lpender3672/sailboat/report/report.tex

\documentclass{article}

\usepackage[utf8]{inputenc}

\usepackage{amsmath, bm}
\usepackage{graphicx}
\usepackage{amssymb}
\usepackage{float}
\usepackage{caption}
\usepackage{subcaption}
\usepackage{hyperref}
\usepackage{tikz}
\usepackage{layout}
\usepackage{booktabs}

\usepackage[margin=1in]{geometry}
\usepackage{listings}
\usepackage{xcolor}
\usepackage{color, colortbl}
\usepackage{textgreek}
\usepackage{mathrsfs}

\usetikzlibrary{calc}
\usetikzlibrary{angles,quotes} % for pic
\usetikzlibrary{patterns,snakes}
\usetikzlibrary{arrows}
\tikzset{>=latex} % for LaTeX arrow head

\setlength{\parskip}{\baselineskip}%
\setlength{\parindent}{0pt}%
\linespread{0.9}

\definecolor{codegreen}{rgb}{0,0.6,0}
\definecolor{codegray}{rgb}{0.5,0.5,0.5}
\definecolor{codepurple}{rgb}{0.58,0,0.82}
\definecolor{backcolour}{rgb}{0.95,0.95,0.92}

\lstdefinestyle{mystyle}{
    backgroundcolor=\color{backcolour},   
    commentstyle=\color{codegreen},
    keywordstyle=\color{magenta},
    numberstyle=\tiny\color{codegray},
    stringstyle=\color{codepurple},
    basicstyle=\ttfamily\footnotesize,
    breakatwhitespace=false,         
    breaklines=true,                 
    captionpos=b,                    
    keepspaces=true,                 
    numbers=left,                    
    numbersep=5pt,                  
    showspaces=false,                
    showstringspaces=false,
    showtabs=false,                  
    tabsize=2
}

\lstset{style=mystyle}

\begin{document}

\title{Model Boat Analysis and Retrofit}
\author{Louis}
\date{September 2025}
\maketitle 

\iffalse
\begin{abstract}
    \centering

\end{abstract}
\fi

%-----------------------------------------------------------------------------------------
\section{Introduction}
%-----------------------------------------------------------------------------------------

% introduction to model boating in cornwall

% unique nice design two keels

A model boat was given to me by my uncle Robin whom he recieved from his uncle Bill.
The boat has a unique twin keel design with the hull being carved from a solid block of wood.

\section{Objective}

With this project being the largest and most complex geometry the objectives were made to test and further my skills in engineering.
My background in aerospace engineering puts me in a good position to tackle these problems and learn new skills in doing so.

\begin{itemize}
    \item Produce an accurate 3D model of the curved hull shape.
    \item Perform quasi-static bouyancy analysis to predict float plane for optimal propeller placement.
    \item Retrofit the boat with a new electric propulsion system.
    \item Write firmware to control the boat remotely using drone radio control equipment.
\end{itemize}

\section{CAD Modelling}

\begin{figure}[H]
    \centering
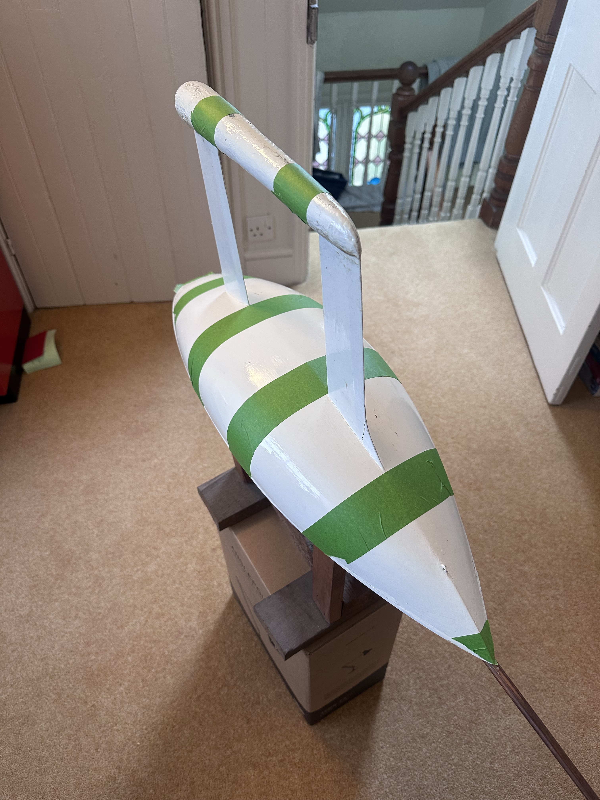
[picture p1: report/figures/IMG_3011.jpg]
    
    \caption{Tape on boat hull to prevent lidar reflections.}
    \label{fig:lidar_tape}
\end{figure}

\begin{figure}[H]
    \centering
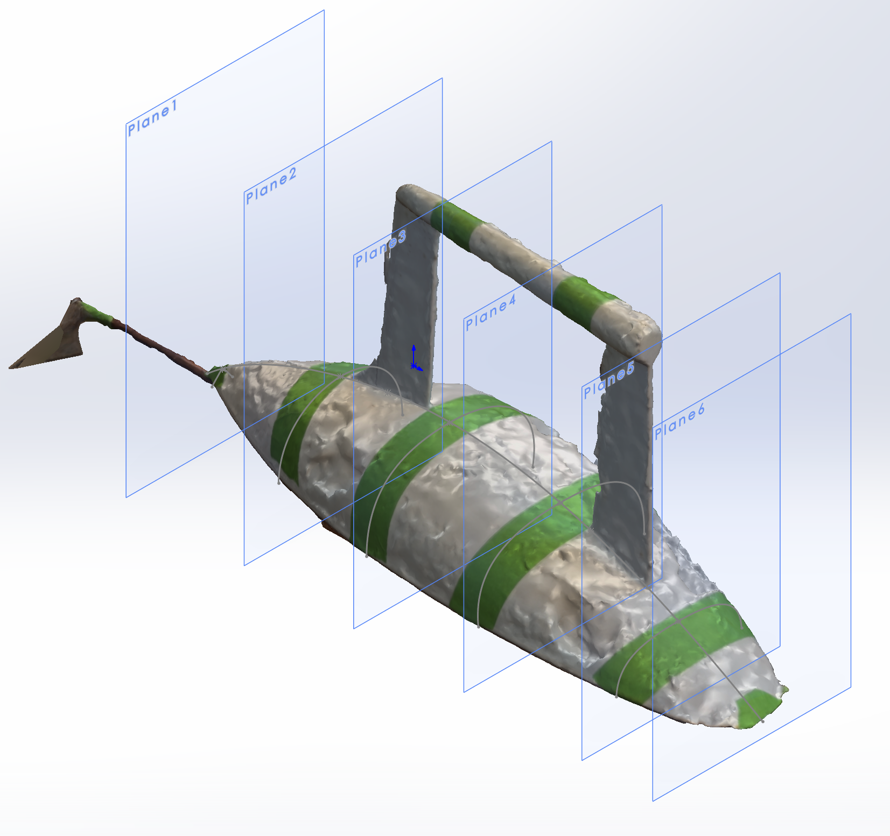
[picture p2: report/figures/2m8uCHP5jN.png]
    
    \caption{3D scan of the boat hull in the CAD package SOLIDWORKS.}
    \label{fig:3d_scan}
\end{figure}

Splines were drawn on the lines of tape which were the smoothest, most geometrically accurate parts of the scanned hull.
Large holes can be seen on the reflective white areas of the hull which was where lidar rays reflected, tricking the scanner into thinking the hull was further away than it actually was.
The splines were then lofted to create a smooth hull surface.
More complex features 

\section{Bouyancy Analysis}

It will be relevant to discuss some theory of bouyancy before discussing the analysis.

Archimedes' principle states that a body submerged in a fluid experiences an upward force equal to the weight of the fluid it displaces.
For the body to be in equilibrium, the bouyancy force must equal the weight of the body.
This simply means we must displace the volume of water that has the same weight as the boat.
However, the average location of the boats weight, known as the center of gravity (CG),
may be different to the averaged location of displaced fluid, known as the center of bouyancy (CB).
This is because even for a boat with evenly distributed weight (uniform density), the submerged volume will be different to the total volume.

When these two points are not aligned, a moment will be created which will cause the boat to rotate until equilibrium is reached.
When CG is aligned vertically above CB, it is possible to be in an unstable equilibrium where a small perturbation will cause the boat to capsize.
A stable equilibrium is reached when CG is vertically below CB, where a small perturbation will create a restoring moment to return the boat to equilibrium.
When CG is further below CB, a larger restoring moment exists and boat can roll to a more extreme angle before becoming unstable and capsizing.
This is why boats have dense keels, to lower the CG and increase stability.

To determine the float plane of the boat, a quasi-static bouyancy analysis was performed in python.
The description 'quasi-static' is used because dynamic fluid forces are not considered as this would require far more complex CFD analysis.
It then follows that this is only valid when the boat rocks or settles at low speeds where dynamic fluid forces ($\rho V^2$) are negligible.

The 3D model was exported as an STL file and processed using the numpy-stl package.
A function is created to slice the mesh 

A simple gui was created to view how the boat settles over time from the quasi-static solver.
Upon loading an STL file and clicking the solve float plane button, an animation plays of the boat settling.
Euler angles (roll, pitch, yaw) are plotted over time to show how the boat stabilises.

\begin{figure}[H]
    \centering
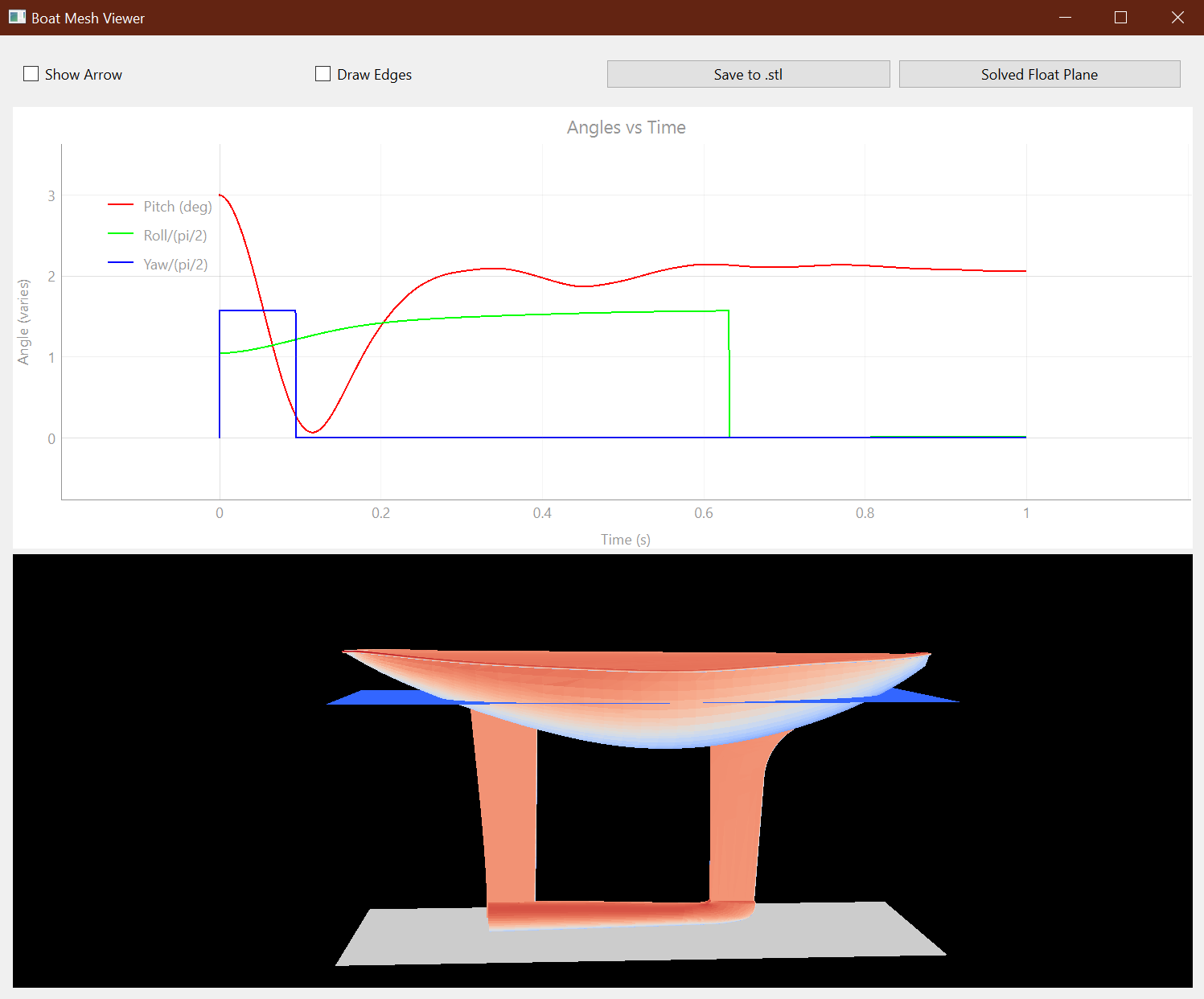
[picture p3: report/figures/XqMwPnm3wm.png]
    
    \caption{Boat bouyancy analysis GUI.}
    \label{fig:boat_gui}
\end{figure}

Figure \ref{fig:boat_gui} shows the solver running with the boat model loaded.
It starts from a perturbed position (3 degrees pitch and 1 degree roll) and settles to a stable equilibrium.
Step changes are seen in the angle plots which may be due to the discontinuities in the volume calculation.
To understand this better, the calculation of submerged volume is explained.

The STL mesh is a series of triangular facets defined by three vertices and a normal vector.
To find the submerged volume, only the traingles with all three vertices below the waterline are considered.
A fourth vertex is taken as the point that defines the water plane and the submerged volume is the sum of tetrahedrons formed by each triangle and this fourth vertex.
The tetrahedron's volume is calculated using the determinant method.
\begin{equation}
    V = \frac{1}{6} \begin{vmatrix}
        x_1 & y_1 & z_1 & 1 \\
        x_2 & y_2 & z_2 & 1 \\
        x_3 & y_3 & z_3 & 1 \\
        x_4 & y_4 & z_4 & 1
    \end{vmatrix}
\end{equation}
The discontinuities in the angle plots are likely due to triangles that are on the edge of being submerged or not.
When a small change in angle causes a triangle to become submerged, it will cause a step change in the volume,
which over many iterations hidden in the x axis scale, causes steep changes in the angle plots.

A smooth response in pitch can be seen which converges nicely to a stable equilibrium of $\sim2$ degrees pitch up.

\subsection{Propeller placement and specification}

An initial guess for the propeller size will be done using non dimensional analysis.
We would like to know the size and speed of the propeller for the size of hull and a target speed of 1.4 m/s (walking pace).

Non dimensional coefficients relevant to the problem are the advance ratio and thrust coefficient.
These are defined with their typical values for displace hull boats below.
\begin{equation}
    J = \frac{V}{nD} \approx 0.6
\end{equation}
\begin{equation}
    C_T = \frac{T}{\rho n^2 D^4} \approx 0.1
\end{equation}

Here $V$ is the boat velocity, $n$ the propeller rotational speed in revolutions per second, 
$D$ the propeller diameter, $T$ the thrust, and $\rho$ the water density.

\subsection*{Scaling relations}
From the definition of $J$, we can write
\begin{equation}
    n = \frac{V}{J D}.
\end{equation}
Substituting this into the definition of $C_T$ gives a relation between thrust, velocity, and propeller diameter:
\begin{equation}
    T = \rho n^2 D^4 C_T 
      = \rho \left( \frac{V}{J D} \right)^2 D^4 C_T.
\end{equation}
Rearranging for $D$ and $n$ yields scaling relations in terms of the boats required thrust (or drag) $T$, velocity $V$, and fluid density $\rho$:
\begin{equation}
    D = \sqrt{\frac{T J^2}{\rho V^2 C_T}},
\end{equation}
\begin{equation}
    n = \frac{V}{J D}.
\end{equation}

For our model boat of length $L = 0.66\,\text{m}$, advancing at walking speed 
$V \approx 1.4\,\text{m/s}$, we adopt $\rho = 1000\,\text{kg/m}^3$, $J = 0.6$, and $C_T = 0.1$.
The required thrust is estimated in the range $T = 2\text{--}4\,\text{N}$ to overcome hull resistance.

\paragraph{Lower drag case ($T=2$\,N):}
\begin{align}
    D &\approx 0.061\,\text{m} \\
    n &\approx 38.5 \,\text{rev/s} \; (2310\,\text{RPM})
\end{align}

\paragraph{Higher drag case ($T=4$\,N):}
\begin{align}
    D &\approx 0.086\,\text{m} \\
    n &\approx 27.2 \,\text{rev/s} \; (1630\,\text{RPM})
\end{align}

These results show that for the target Froude number ($Fr \approx 0.55$), 
propeller diameters in the range $60$--$90$\,mm with rotational speeds 
$1600$--$2300$\,RPM are consistent with typical open-water coefficients.
If physical constraints limit the diameter below this range, higher rotational 
speeds and larger thrust coefficients must be accepted, leading to lower efficiency.

\subsection{CFD analysis of hull resistance}

A CFD analysis was done in solidworks flow simulation to estimate the drag of the hull at the target speed of 1.4 m/s.

\begin{figure}[H]
    \centering
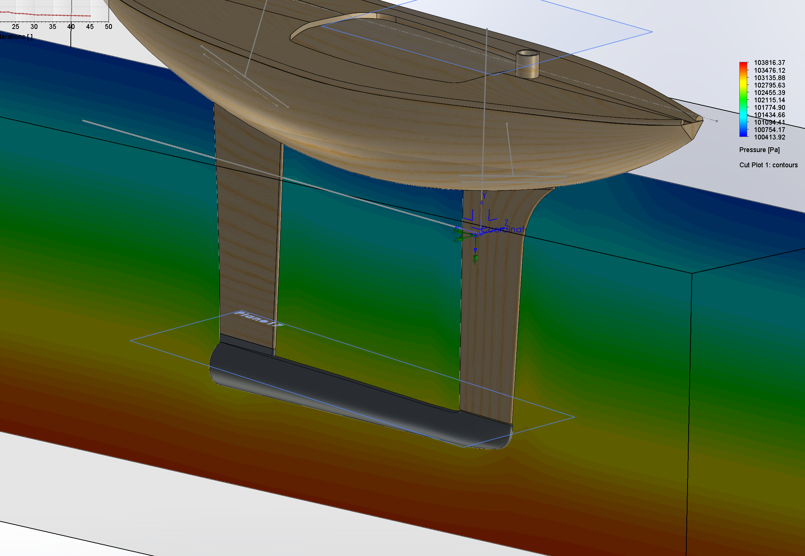
[picture p4: report/figures/CFD.png]
    
    \caption{CFD analysis of boat hull at 1.4 m/s.}
    \label{fig:boat_cfd}
\end{figure}

Figure \ref{fig:boat_cfd} shows a center plane cut of the CFD analysis where the clear hydrostatic pressure distribution can be seen.
A spike in pressure is seen at the front of both keels where the flow stagnates, and reduced pressure can be seen at places of high curvature, where the flow
accelerates over the hull and the pressure drops.

\begin{figure}[H]
    \centering
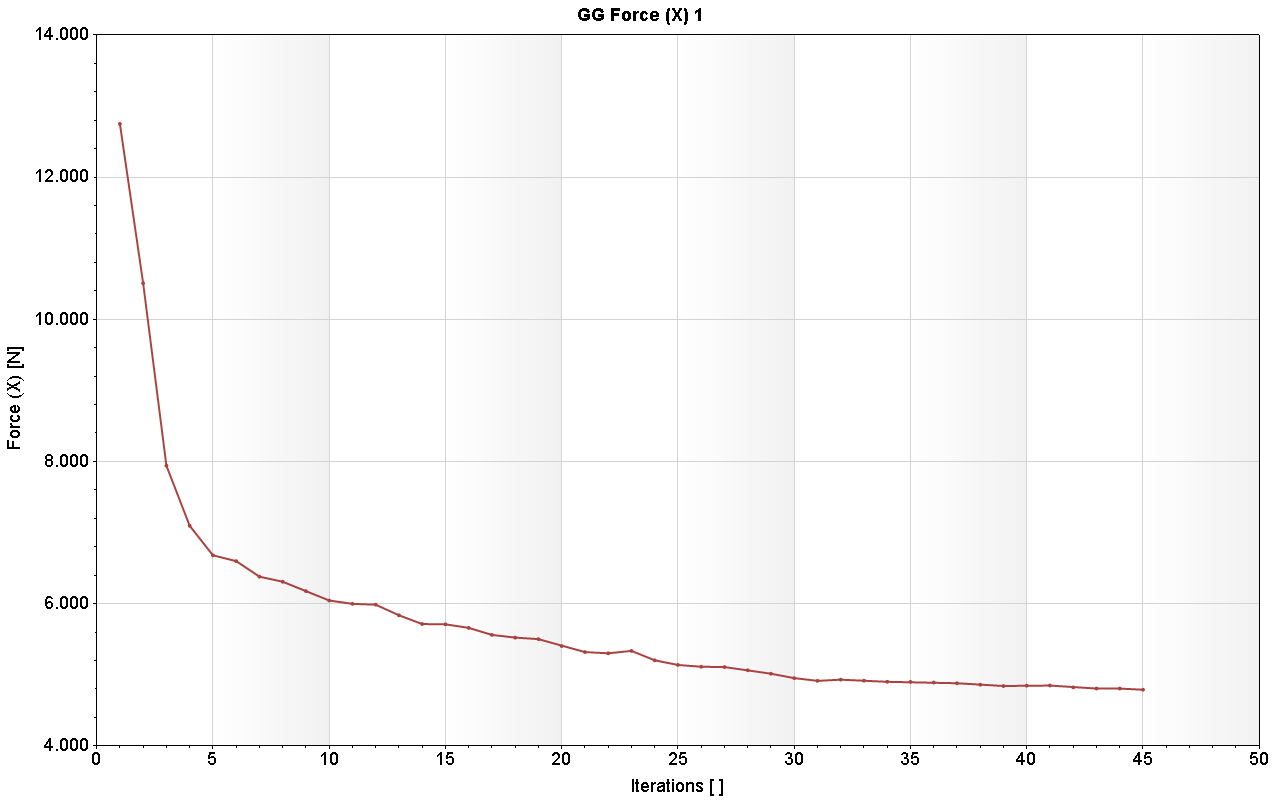
[picture p5: report/figures/GG Force (X) 1.png]
    
    \caption{Drag force against iterations on the boat hull at 1.4 m/s.}
    \label{fig:boat_cfd_drag}
\end{figure}

Figure \ref{fig:boat_cfd_drag} shows the drag force on the hull over the iterations of the solver.
The solver converges nicely to a drag force of 4.8 N which is higher than the initial estimate of 2-4 N.
This is likely due to the much wider beam of the hull increasing the wetted area compared to a typical slender displacement hulls.

The value of 4.8 N means we are closer to the case of higher drag in the propeller sizing analysis.
This means we will want a larger diameter propeller than initially thought, closer to 90 mm.
This isnt possible due to the limited space between the keels so the maximum size of 50 mm will be used.
The rotational speed is then given by the scaling relations as 44.6 rev/s (2676 RPM).

\subsection{Propeller design}

Software meant for the design of drone propellers was used for the model boat propeller.
This was software I developed for my fourth year project on drone propeller acoustics.
Blade element momentum theory is used to predict the thrust, torque, power and efficiency of a propeller given its geometry and operating conditions.
It also implements acoustic calculations for air propellers which is not relevant for this project.

The density and speed of sound is set to that of sea water ($\rho = 1025$ kg/m$^3$, $c = 1540$ m/s).
The size of $D = 50$ mm and rotational speed of $n = 44.6$ rev/s are set.

\begin{figure}[H]
    \centering
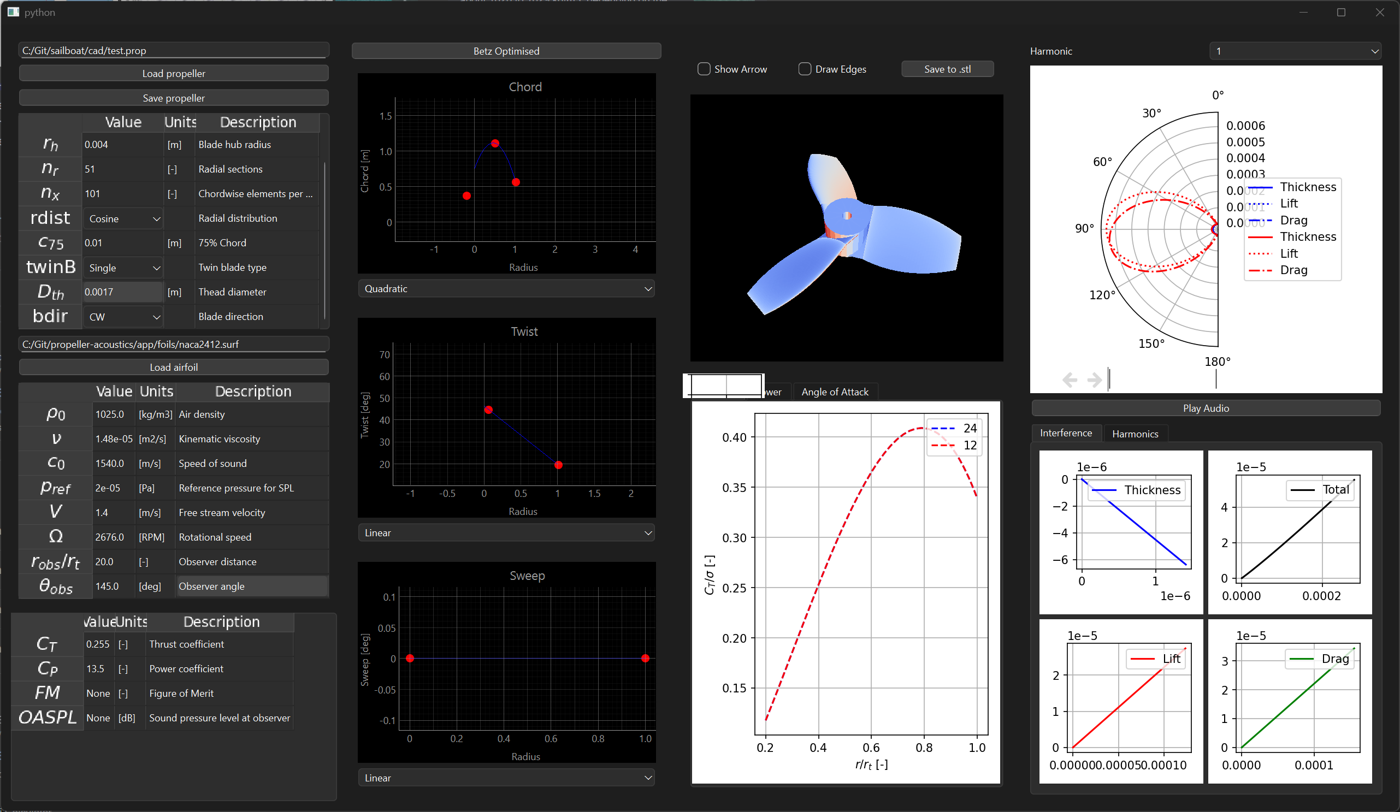
[picture p6: report/figures/prop_design.png]
    
    \caption{Propeller design for the boat from drone propeller software \cite{year4}.}
    \label{fig:boat_prop_design}
\end{figure}

Chord, twist and sweep distributions are set to rough values for now but could be iterated upon later.
The graph shown bottom center of figure \ref{fig:boat_prop_design} shows the blade loading profile defined as the local thrust coefficient over local solidity (circumferential area fraction).

The software does not account for cavitation which is a complex phenomenon where low pressure regions form bubbles in the water.
This causes damage to commercial ship propellers and could be of concern for this higher loaded small propeller.
Ideally, a specific non-dimensional caviation number should be above a threshold limit to avoid cavitation.
This is defined as
\begin{equation}
    \sigma = \frac{p_\infty - p_v}{\tfrac{1}{2}\rho V^2}
\end{equation}

where $\sigma$ is the cavitation number,
$p_\infty$ is the ambient pressure,
$p_v$ is the vapour pressure,
$\rho$ is the water density, and
$V$ is the inflow velocity.

\section{Retrofitting work}

\subsection{CAD modifications}

\begin{figure}[H]
    \centering
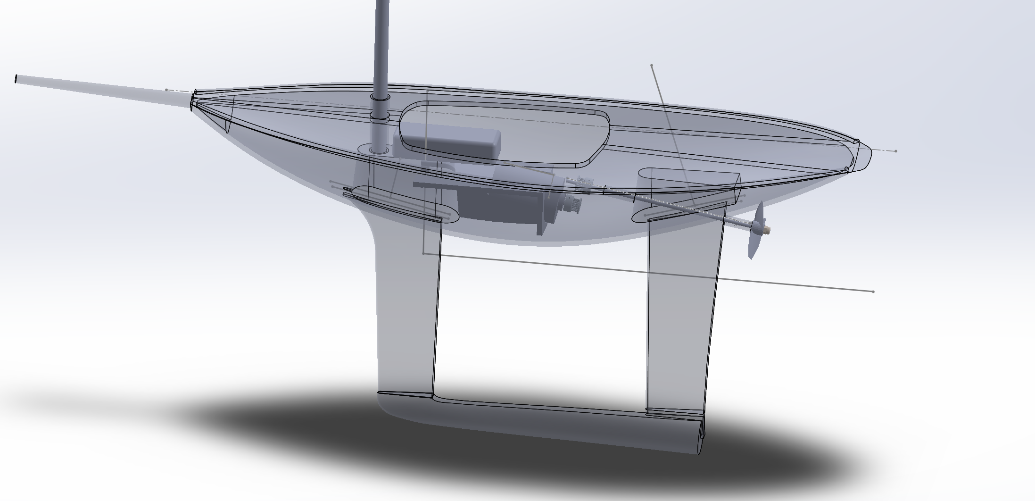
[picture p7: report/figures/W7m34cP29W.png]
    
    \caption{Final CAD model of the boat hull with propeller shaft installed}
    \label{fig:final_cad}
\end{figure}

It was decided to use a belt drive between motor and propeller shaft axel to allow the motor to be mounted on axis with the hull, without sticking out.
This also lowers the centre of mass and allows for different gear ratios, should the speed range need adjusting.

\subsection{Hull modifications}

Holes were cut to fit a shaft for the propeller and rudder.
A large hole was cut in the top of the hull with a dremel to fit the electronics and battery.
A 1:1 scale printout of the hull was stuck on to ensure the hole was in the correct place and of the correct size.
A temporary cover was 3D printed to seal the hole after the electronics were installed.
In the future this will be sealed either with an improved raised cabin or lowered cockpit.

\begin{figure}[H]
    \centering
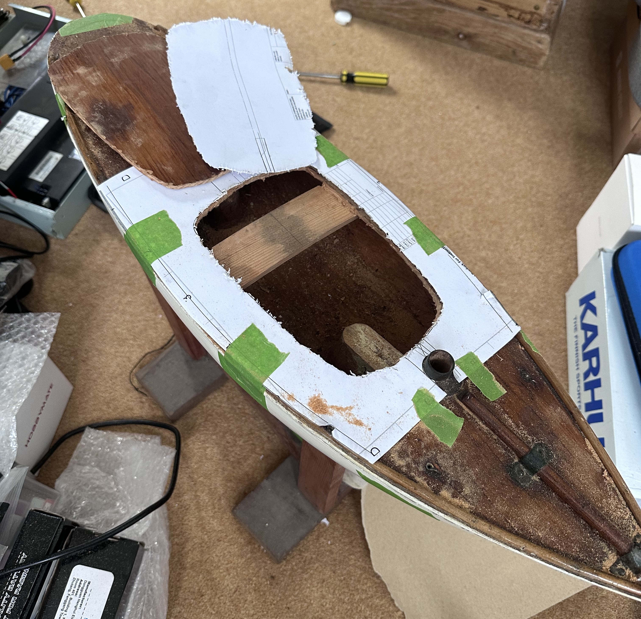
[picture p8: report/figures/holes.jpg]
    
    \caption{Hole cut in the hull to fit propeller shaft, and electronics bay.}
    \label{fig:hull_holes}
\end{figure}

\begin{figure}[H]
    \centering
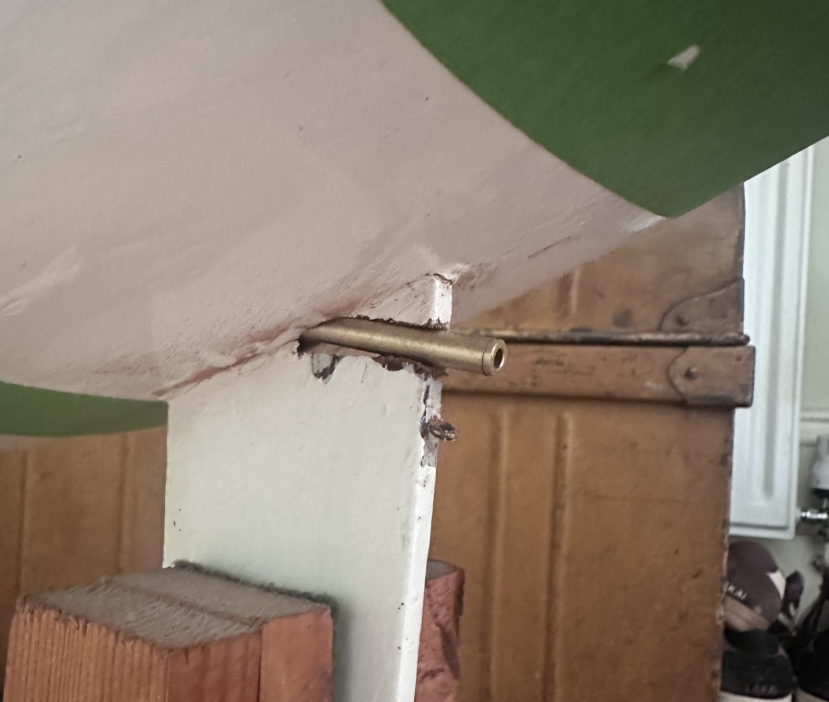
[picture p9: report/figures/prop_shaft.jpg]
    
    \caption{Propeller shaft installed in the hull.}
    \label{fig:prop_shaft}
\end{figure}

A jig was made to drill the hole for the propeller shaft at the correct angle.
This was done by cutting the boat hull geometry from a block with a hole at the correct angle.
The block would then sit up against the keel and allow a precise hole to be drilled.
The shaft is then epoxied in place with the internal axel sealed with thick silicone grease to prevent water getting in.

\subsection{Electronics and firmware}

Initially I planned to use a drone motor and ESC to power the propeller.
However, this was not feasible as these are designed to have a constant airflow over them to cool both the ESC and motor itself.
This is not possible in the enclosed hull of the boat.
Additionally, the low speeds and high loading required earlier in the analysis are not suitable for drone motors which are designed to spin at high RPM with low torque.
High performance boat motors exist which use water cooling jackets, however these are expensive and surpass the requirements of the project.
Instead, a brushed DC motor was used, driven by a high current H bridge motor driver.
These are much simpler devices which can be easily cooled with a small heatsink.
A 3s LiPo battery is used to power the motor, providing a nominal 11.1V and up to 20A of current.
The motor driver also has current shunt resistors, allowing the current to be measured by the rp2040 microcontroller.
It was originally planned to use a cheap 16 bit arudino based board, however, the remote control reciever required 32 bits to interface with it.
The rp2040 was chosen as a cheap but powerful microcontroller with a dual core ARM Cortex M0+ processor running at 133MHz.
The reciever also required 5V which can also be used to power the pico and so a regulator was used to step down the 11.1V battery supply.
A radiomaster boxer transmitter was used to control the boat remotely.

\begin{figure}[H]
    \centering
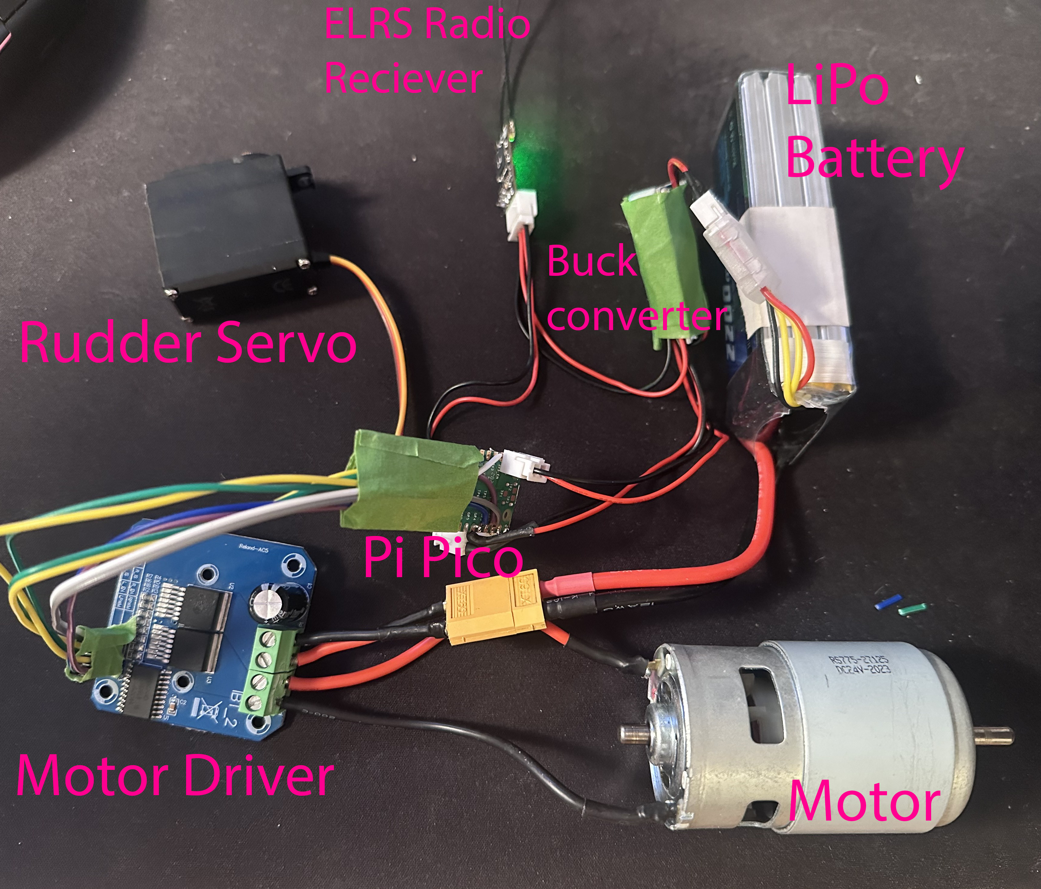
[picture p10: report/figures/electronics_annotated.png]
    
    \caption{Electronics outside of the boat hull.}
    \label{fig:boat_electronics}
\end{figure}

The firmware was written in C++ using the Arduino framework for ease of use.
The CRSFforArduino library was used to interface with the CRSF protocol of the receiver.
Essentially 1024 levels of throttle sent over 2.4GHz, read over CRSF were mapped to 256 motor PWM levels and 1000-2,000us servo pulse widths.
The full code is given in the appendix as listing \ref{lst:boat_firmware}.

\section{Float test and results}

Unfortunately due to time constraints the installation of the electronics and testing of the system was not completed.
The partial installation of the electronics also means the weight distribution is not final and so the bouyancy analysis may not be accurate.
Additionally, the hull currently is not fully watertight and so further sealing work is required before testing.

\section{Conclusion}

A hull was successfully modelled in CAD from a 3D scan and virtually modified to fit a propeller shaft and controlling electronics.
Quasi-static bouyancy analysis was performed to predict the float plane of the boat and inform propeller placement.
Non dimensional analysis was used to estimate the required propeller size and speed, which was refined using CFD analysis of the hull drag.
The analysis and CAD objectives, while not experimentally validated, were successfully completed.
This was due to the scale of the project and time constraints meant the retrofitting and testing objectives were not fully completed.
Throughout the project I developed skills modelling complex geometries, performing static and dynamic fluid analysis, and embedded motor control.

\section{Future work}
With the project objectives partially completed, there is still much work to be done to finish the retrofit and test the boat.
\begin{itemize}
    \item Finish installation of electronics and waterproofing of hull.
    \item Test the boat in a bath tub to validate water tightness and bouyancy analysis.
    \item Test on open water to validate propulsion system design.
    \item Add telemetry to send boat data (current, speed, battery voltage, GPS module?) back to transmitter.
    \item Design and 3D print a raised cabin to cover the electronics bay.
    \item Fit a mast and boom for sailing functionality.
\end{itemize}

\section{Appendix}

\begin{table}[h!]
\centering
\begin{tabular}{l l r}
\hline
\textbf{Item} & \textbf{Description} & \textbf{Cost (£)} \\
\hline
Rudder Servo motor         &  & 15 \\
Propeller Motor            &  & 30 \\
Motor controller           &  & 15 \\
Conformal coating          &  & 20 \\
ELRS Receiver              &  & 30 \\
Pi Pico                    &  & 5  \\
Buck converter             &  & 4  \\
LiPo Battery               &  & 20 \\
Connectors                 &  & 10 \\
3D printed material        &  & 5  \\
Polyester braided cable    &  & 6  \\
Ripstop Nylon sail         &  & 7  \\
Propeller shaft            &  & 20 \\
\hline
\textbf{Total} &  & \textbf{187} \\
\hline
\end{tabular}
\caption{Breakdown of project component costs.}
\label{tab:component_costs}
\end{table}

% list listing of code

\begin{lstlisting}[language=C++, caption=RP2040 boat motor and servo control firmware, label=lst:boat_firmware]
    // RP2040 (Raspberry Pi Pico) + CRSF receiver + motor driver
#include <Arduino.h>
#include <CRSFforArduino.hpp>
#include <Servo.h>

#include "hardware/uart.h"
#include "hardware/gpio.h"

CRSFforArduino crsf(&Serial1, 1, 0);

// Low-level UART configuration
#define UART_ID      uart0
#define BAUD_RATE    420000
#define DATA_BITS    8
#define STOP_BITS    1
#define PARITY       UART_PARITY_NONE
#define UART_TX_PIN  0
#define UART_RX_PIN  1

const uint8_t PIN_R_EN = 10;
const uint8_t PIN_L_EN = 11;
const uint8_t PIN_RPWM = 2;
const uint8_t PIN_LPWM = 3;
const uint8_t PIN_R_IS = 26;  // ADC0
const uint8_t PIN_L_IS = 27;  // ADC1

const uint8_t PIN_SERVO = 4;
Servo servo;

static inline void enableDriver(bool enable) {
  digitalWrite(PIN_R_EN, enable ? HIGH : LOW);
  digitalWrite(PIN_L_EN, enable ? HIGH : LOW);
}

// speed: -255..255 (negative = reverse)
static inline void setSpeed(int16_t speed) {
  if (speed > 255) speed = 255;
  if (speed < -255) speed = -255;
  if (speed > 0) {
    analogWrite(PIN_RPWM, speed);
    analogWrite(PIN_LPWM, 0);
  } else if (speed < 0) {
    analogWrite(PIN_RPWM, 0);
    analogWrite(PIN_LPWM, -speed);
  } else {
    analogWrite(PIN_RPWM, 0);
    analogWrite(PIN_LPWM, 0);
  }
}

static inline uint16_t readCurrentRaw() {
  return analogRead(PIN_R_IS) + analogRead(PIN_L_IS);
}

int16_t usToSpeed(int us) {
  if (us < 1000) us = 1000;
  if (us > 2000) us = 2000;
  long val = map(us, 1000, 2000, -255, 255);
  return (int16_t)val;
}

static volatile bool g_linkUp = false;

static void onRcChannels(serialReceiverLayer::rcChannels_t *rcChannels);

static void onLinkUp() {
  g_linkUp = true;
  enableDriver(true);
  setSpeed(0);
  Serial.println("CRSF link: UP");
}

static void onLinkDown() {
  g_linkUp = false;
  setSpeed(0);
  enableDriver(false);
  Serial.println("CRSF link: DOWN");
}

void setup() {
  Serial.begin(115200);

  pinMode(PIN_R_EN, OUTPUT);
  pinMode(PIN_L_EN, OUTPUT);
  pinMode(PIN_RPWM, OUTPUT);
  pinMode(PIN_LPWM, OUTPUT);
  pinMode(PIN_R_IS, INPUT);
  pinMode(PIN_L_IS, INPUT);
  enableDriver(false);
  setSpeed(0);

  // Servo 1000-2000us range
  servo.attach(PIN_SERVO, 1000, 2000);
  servo.writeMicroseconds(1500);

  // CRSF link callbacks
  crsf.setLinkUpCallback(onLinkUp);
  crsf.setLinkDownCallback(onLinkDown);
  crsf.setRcChannelsCallback(onRcChannels);

  // magic uart setup (anything missing and it breaks)
  uart_init(UART_ID, BAUD_RATE);
  gpio_set_function(UART_TX_PIN, GPIO_FUNC_UART);
  gpio_set_function(UART_RX_PIN, GPIO_FUNC_UART);
  uart_set_hw_flow(UART_ID, false, false);
  uart_set_format(UART_ID, DATA_BITS, STOP_BITS, PARITY);
  uart_set_fifo_enabled(UART_ID, false);

  crsf.begin(BAUD_RATE);
  Serial.println("Waiting for CRSF link...");

  uint32_t t0 = millis();
  while (!g_linkUp && (millis() - t0 < 8000)) {
    crsf.update();
    Serial.print(".");
    delay(50);
  }
  if (!g_linkUp) {
    Serial.println("\nCRSF link not detected (timeout). Motor stays disabled.");
  }
}

void loop() {
  crsf.update();

  if (!g_linkUp) {
    setSpeed(0);
  servo.writeMicroseconds(1500);
    return;
  }

  // CH3 (throttle-like) to drive motor
  uint16_t ch3_us = crsf.rcToUs(crsf.getChannel(3));
  int16_t speed = usToSpeed((int)ch3_us);
  setSpeed(speed);

  // Channel 4 servo rudder
  uint16_t ch4_us = crsf.rcToUs(crsf.getChannel(4));
  servo.writeMicroseconds(ch4_us);

  static uint32_t last = 0;
  uint32_t now = millis();
  if (now - last > 250) {
    last = now;
  Serial.print("CH3(us): "); Serial.print(ch3_us);
    Serial.print("  speed: "); Serial.print(speed);
  Serial.print("  CH4(us): "); Serial.print(ch4_us);
    Serial.print("  Iraw: "); Serial.println(readCurrentRaw());
  }
}

static void onRcChannels(serialReceiverLayer::rcChannels_t * /*rcChannels*/) {
  if (!g_linkUp) {
    onLinkUp();
  }
}

\end{lstlisting}

\begin{thebibliography}{9}

  \bibitem{year4}
  L. W. Pender
  \emph{Acoustic Signatures of Quadcopter Propellers.}
  University of Cambridge,
  2025.

\end{thebibliography}

\end{document}
