lpender3672/sailboat/report/costs.xlsx

Item | Description | Cost
Rudder Servo motor |  | 15
Propeller Motor |  | 30
Motor controller |  | 15
Conformal coating |  | 20
ELRS Reciever |  | 30
Pi Pico |  | 5
Buck converter |  | 4
LiPo Battery |  | 20
Connectors |  | 10
3D printed material |  | 5
Polyester braided cable |  | 6
Ripstop Nylon sail |  | 7
Propeller shaft |  | 20
 |  | 187
