lpender3672/sailboat/cad/jig^boat_asm.STL

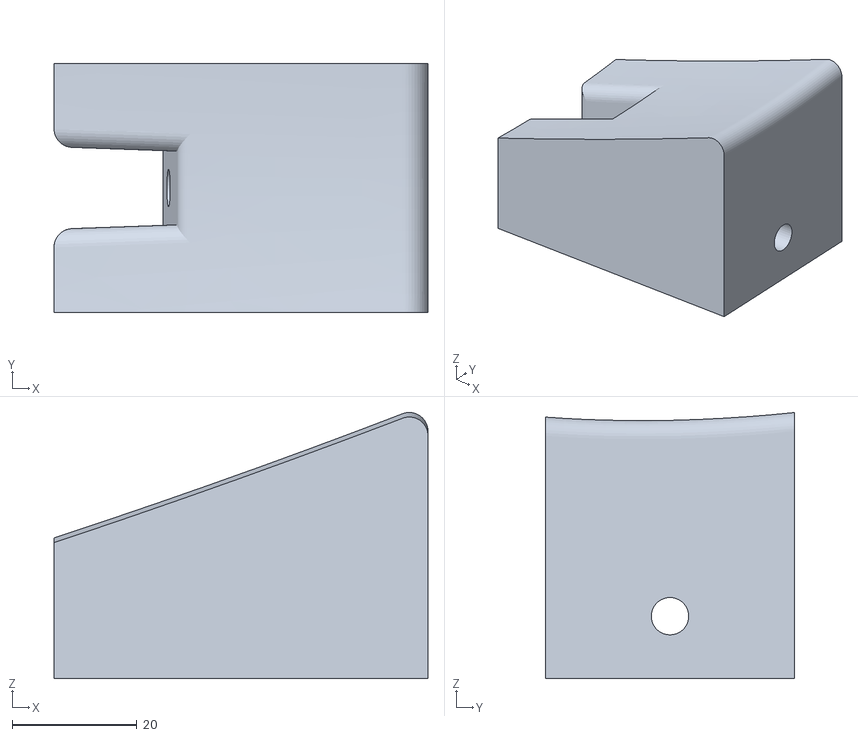
[picture p13: CAD file, 2025-09-22]
cad/jig^boat_asm.STL
60.0 x 40.0 x 42.7
