lpender3672/sailboat/cad/endjig^COM_measurer_boat_asm.STL

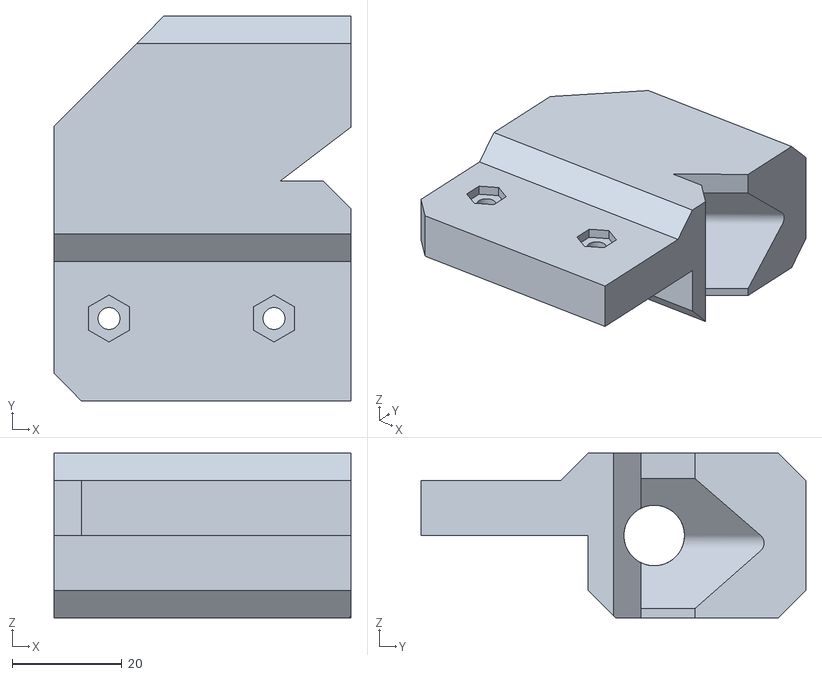
[picture p14: CAD file, 2025-09-16]
cad/endjig^COM_measurer_boat_asm.STL
54.0 x 70.0 x 30.0
