lpender3672/sailboat/cad/endjig-bow^COM_measurer_boat_asm.STL

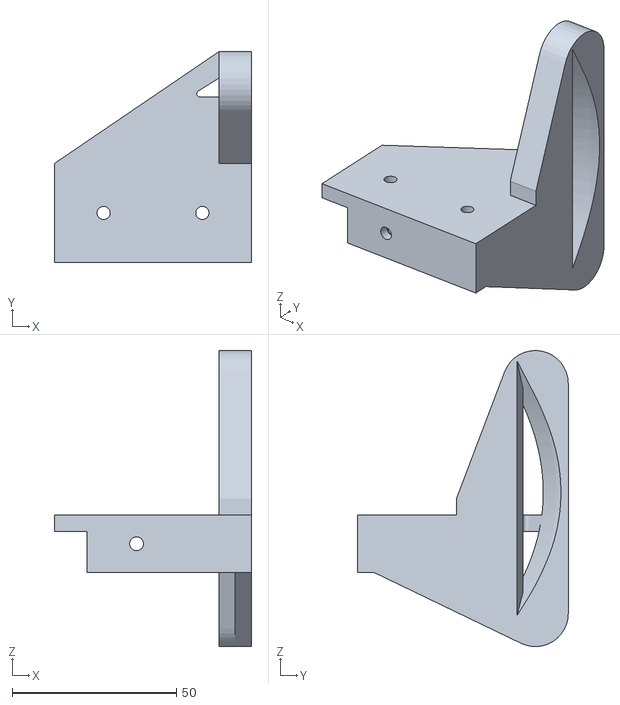
[picture p15: CAD file, 2025-09-16]
cad/endjig-bow^COM_measurer_boat_asm.STL
60.0 x 64.0 x 90.0
