lpender3672/sailboat/cad/con^COM_measurer_boat_asm.STL

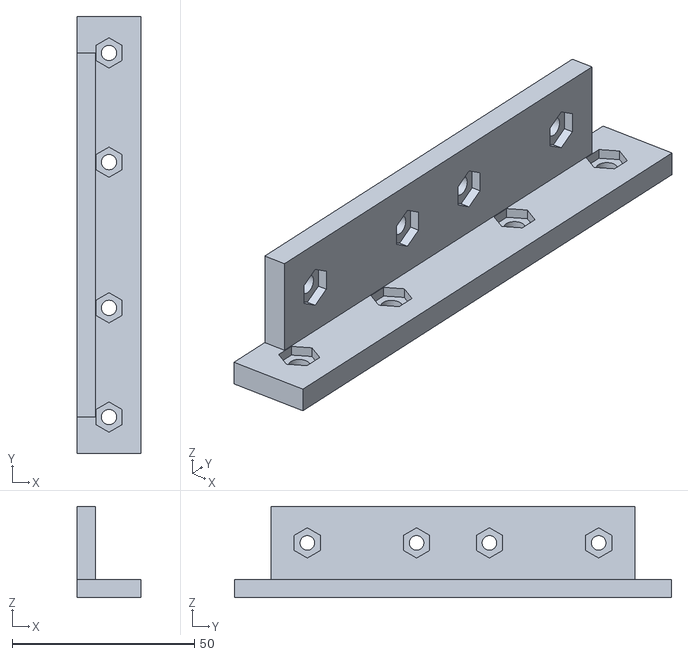
[picture p16: CAD file, 2025-09-16]
cad/con^COM_measurer_boat_asm.STL
17.5 x 120.0 x 25.0
