lpender3672/sailboat/cad/beam^COM_measurer_boat_asm.STL

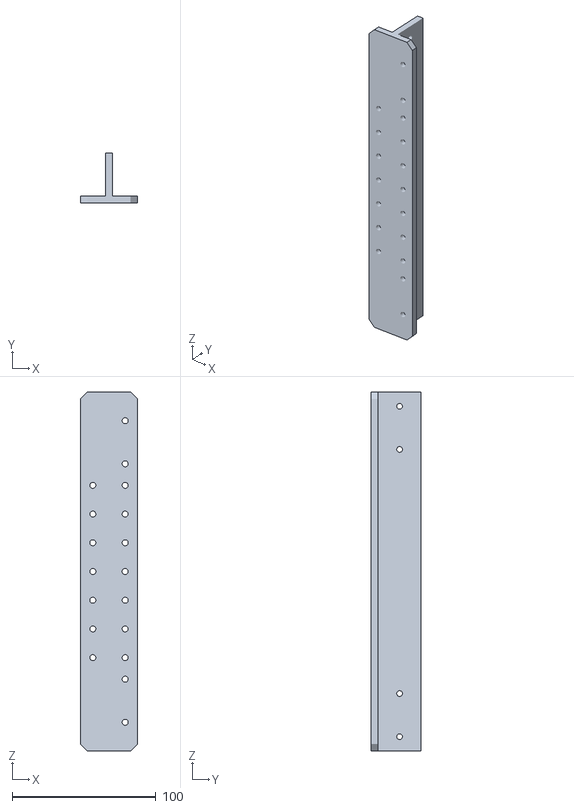
[picture p17: CAD file, 2025-09-16]
cad/beam^COM_measurer_boat_asm.STL
40.0 x 35.0 x 250.0
