lpender3672/sailboat/cad/stlls/frame.STL

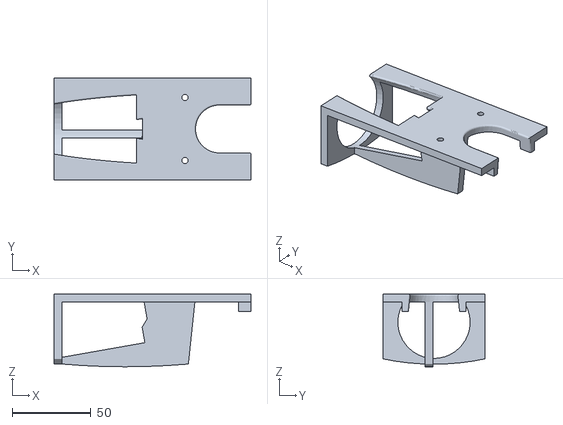
[picture p18: CAD file, 2025-10-24]
cad/stlls/frame.STL
125.0 x 65.0 x 46.1
