lpender3672/sailboat/cad/Boat.SLDPRT

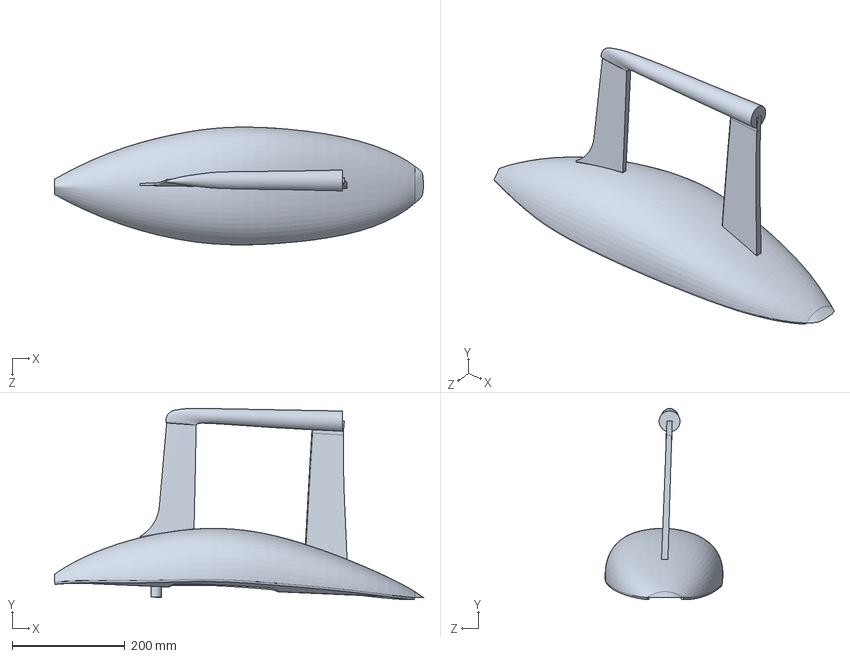
[picture p19: CAD file, 2025-10-23]
cad/Boat.SLDPRT
653.1 x 338.9 x 208.5 mm
