lpender3672/sailboat/cad/stlls/key.STL

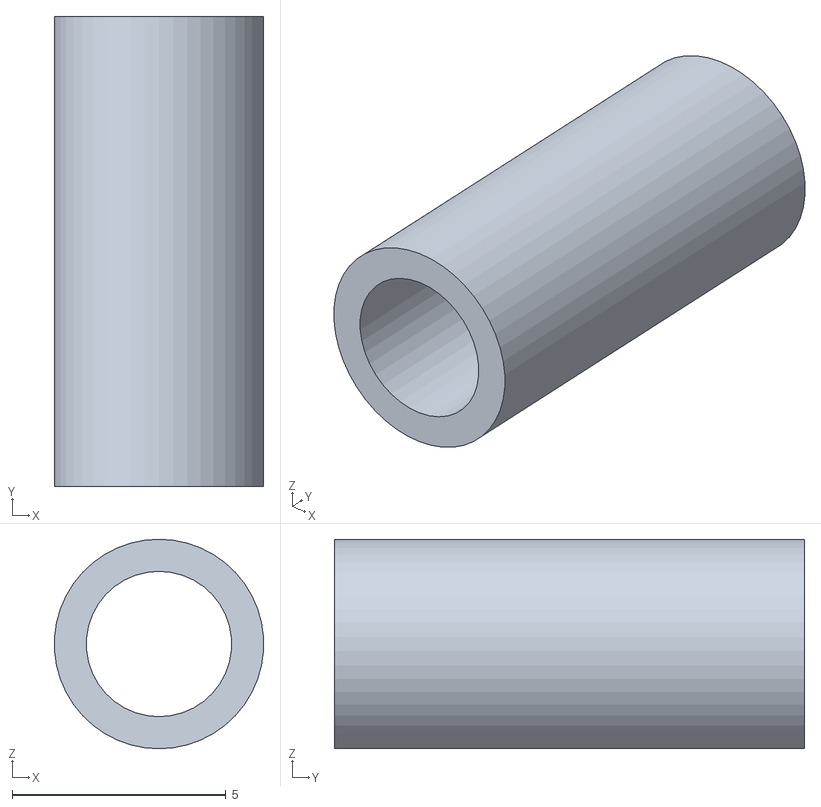
[picture p20: CAD file, 2025-10-23]
cad/stlls/key.STL
4.89 x 11.0 x 4.90
