lpender3672/sailboat/cad/test.stl

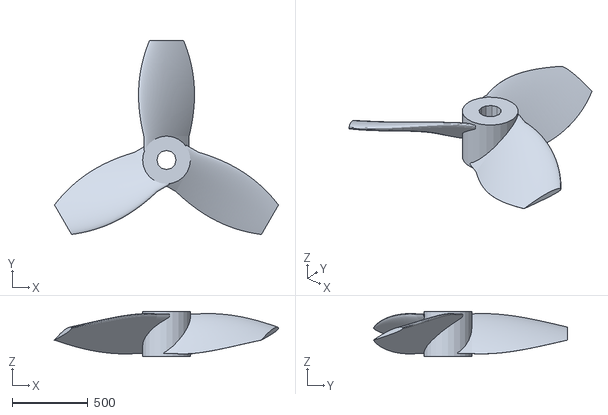
[picture p21: CAD file, 2025-10-23]
cad/test.stl
1475.5 x 1278.0 x 297.5
