lpender3672/sailboat/cad/belt_gear.SLDPRT

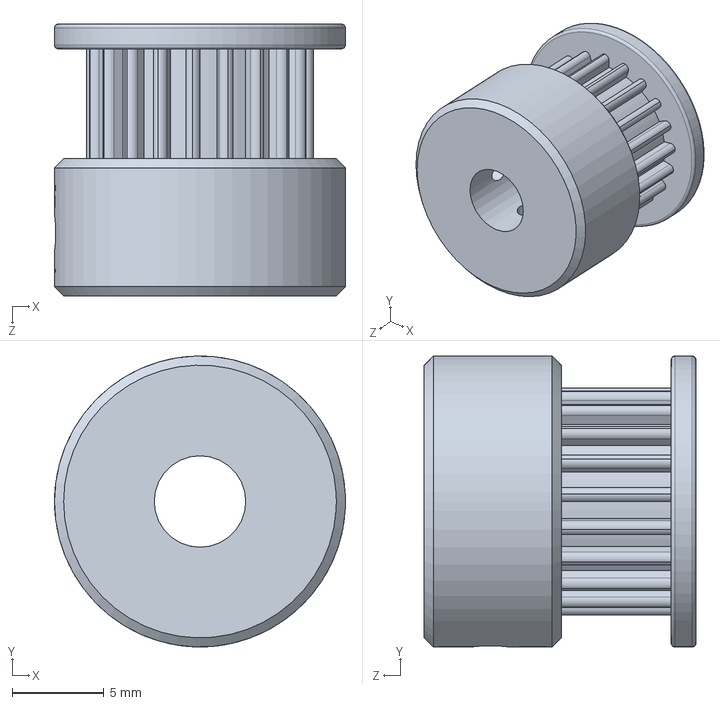
[picture p22: CAD file, 2025-10-23]
cad/belt_gear.SLDPRT
15.9 x 15.9 x 14.9 mm
