lpender3672/sailboat/cad/test (repaired).stl

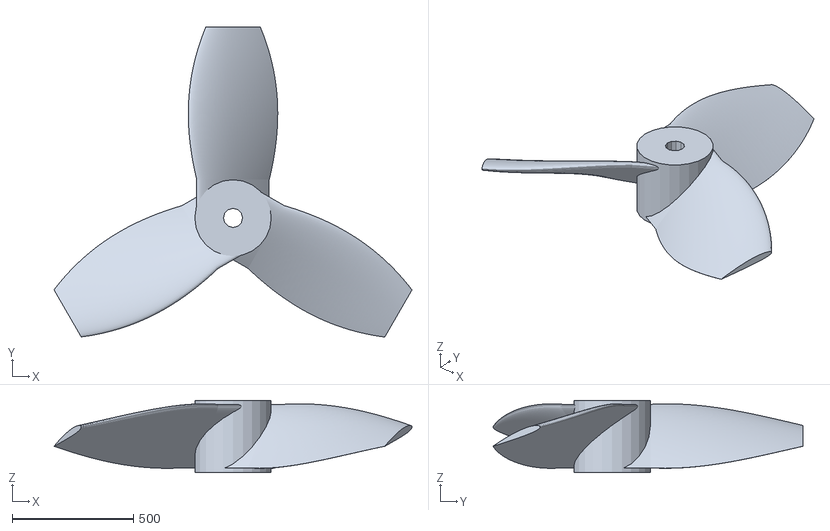
[picture p23: CAD file, 2025-09-28]
cad/test (repaired).stl
1475.5 x 1278.0 x 297.5
