lpender3672/sailboat/cad/boat_asm.SLDASM

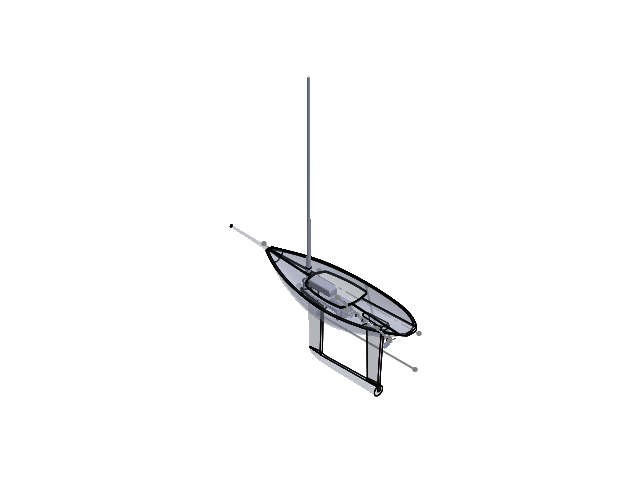
[picture p24: CAD file, 2025-10-24]
cad/boat_asm.SLDASM
Boat
motor^electronics_boat_asm
belt_gear x 2
battery^electronics_boat_asm
frame^boat_asm
axel^shaft_boat_asm
key
torque nut 01_iso
prop
mast^sail_boat_asm
