lpender3672/sailboat/(list of files, cad)

Other CAD files:
cad/key.SLDPRT
cad/prop.SLDPRT
cad/Boat.SLDDRW
cad/Boat.STL
cad/test.obj
