lpender3672/sailboat/(commit log)

2025-08-28 pio and cad initial uploads
2025-09-16 boat cad files and float plane stuff
    [Boat.SLDDRW, Boat.STL, beam^COM_measurer_boat_asm.STL, boat_asm.SLDASM, con^COM_measurer_boat_asm.STL, endjig-bow^COM_measurer_boat_asm.STL, endjig^COM_measurer_boat_asm.STL]
2025-09-16 extra unsaved cad stuff
    [boat_asm.SLDASM]
2025-09-16 gpt has apparently sped up my code
    [Boat.SLDDRW]
2025-09-16 decided to change to DC motor using a motor driver i had laying around. wanted to use a cheap arduino for electronics but crsf remote requires 32bit so ive gone with rp2040 so if the electrics get we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
2025-09-18 need to do hull modifications
2025-09-20 working code to remote control servo and prop
2025-09-21 prop shaft jig
    [boat_asm.SLDASM, jig^boat_asm.STL]
2025-09-28 weekends work on boat. wish i played more borderlands 4 anyway had the nice idea of doing a lil solidworks flow sim to get dynamic forces this is then put into the dimensional analysis to get approx 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
    [Boat.SLDPRT, test (repaired).stl, test.obj, test.stl]
2025-10-23 solidworks is behaving well and progress was made
    [Boat.SLDPRT, belt_gear.SLDPRT, boat_asm.SLDASM, frame.STL, key.SLDPRT, key.STL, prop.SLDPRT, test.stl]
2025-10-23 cad fig and end of day
    [Boat.SLDPRT, boat_asm.SLDASM, frame.STL]
2025-10-24 finished iNtErIm report
    [boat_asm.SLDASM, costs.xlsx, frame.STL]
