lpender3672/sailboat/cad/tex_u1_v1_normal.jpg

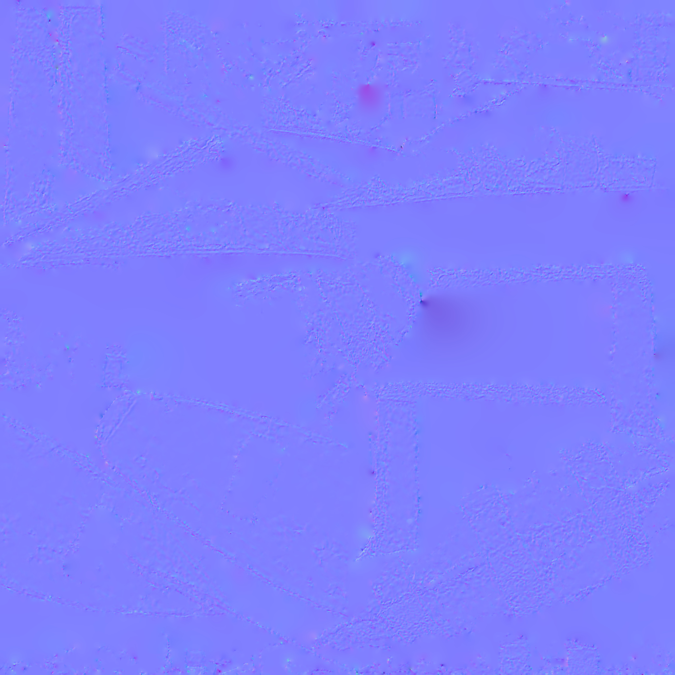
cad/tex_u1_v1_normal.jpg
